wsavoie/HardwareSmarticles/README.md

# HardwareSmarticles
Contains all the relevant files for the hardware version of the smarticle as of 8/3/15
