wsavoie/HardwareSmarticles/Smarticle SolidWorks/Solar - Assembly.SLDASM

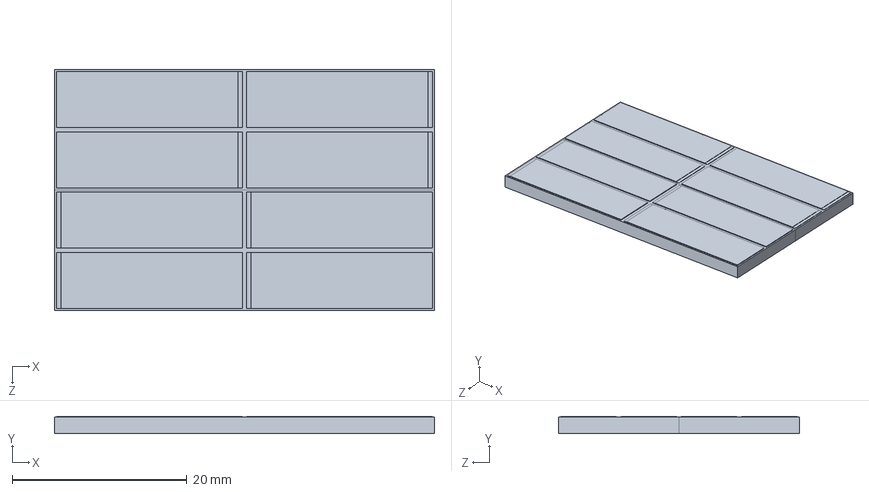
[picture p2: CAD file, 2015-08-03]
Smarticle SolidWorks/Solar - Assembly.SLDASM
43.5 x 2.00 x 27.6 mm
Arm - Solar Panel x 2
