wsavoie/HardwareSmarticles/Smarticle SolidWorks/Switch - Assembly.SLDASM

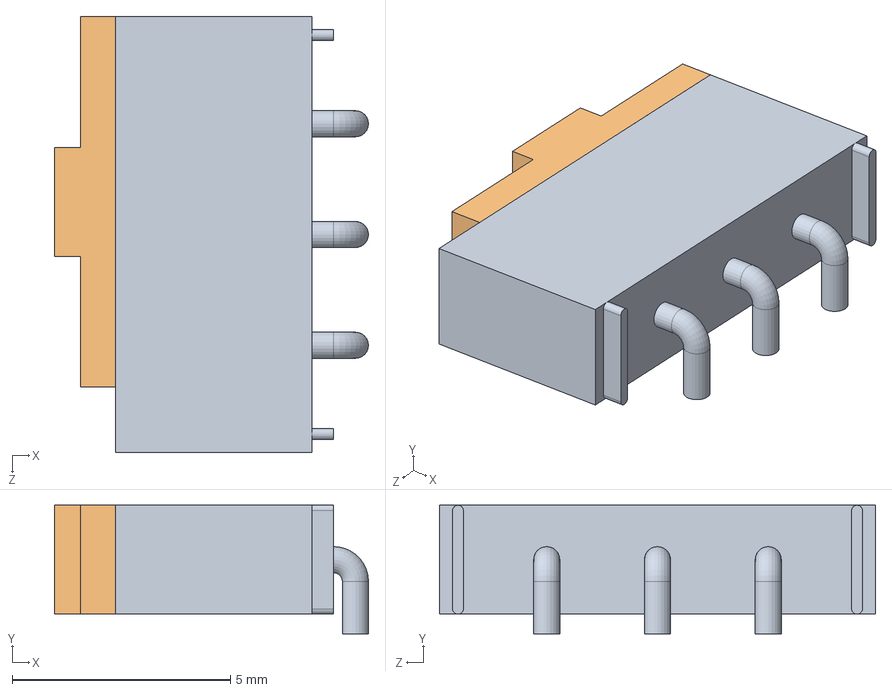
[picture p3: CAD file, 2015-08-03]
Smarticle SolidWorks/Switch - Assembly.SLDASM
7.20 x 2.95 x 10.0 mm
Switch - Body
Switch - Rocker
