wsavoie/HardwareSmarticles/Smarticle SolidWorks/Battery - Assembly.SLDASM

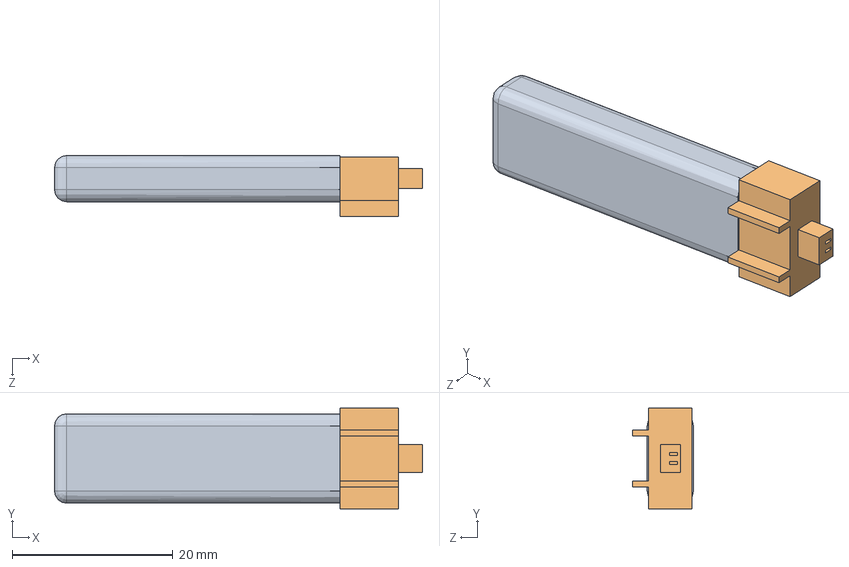
[picture p4: CAD file, 2015-08-03]
Smarticle SolidWorks/Battery - Assembly.SLDASM
45.8 x 12.5 x 7.57 mm
Battery - Body
Battery - Connector
