wsavoie/HardwareSmarticles/Smarticle SolidWorks/Servo - Assembly.SLDASM

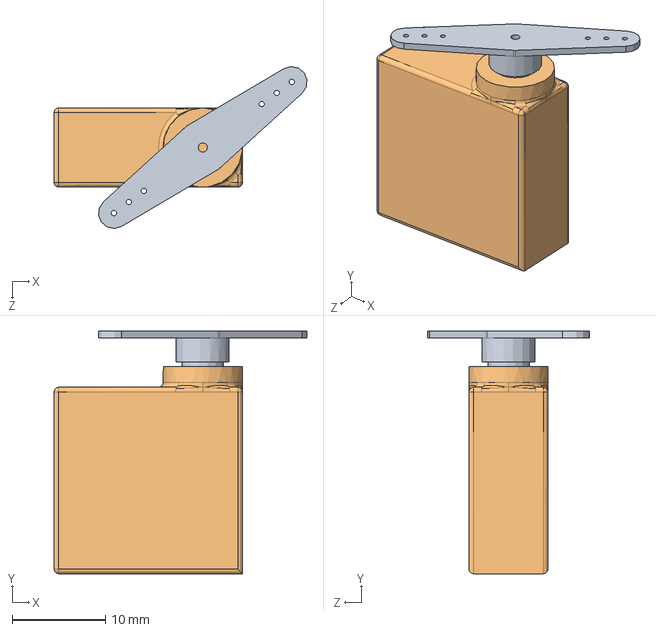
[picture p5: CAD file, 2015-08-03]
Smarticle SolidWorks/Servo - Assembly.SLDASM
27.1 x 26.0 x 17.4 mm
Servo - Body
Servo - Horn
