wsavoie/HardwareSmarticles/Smarticle SolidWorks/PCB - Assembly.SLDASM

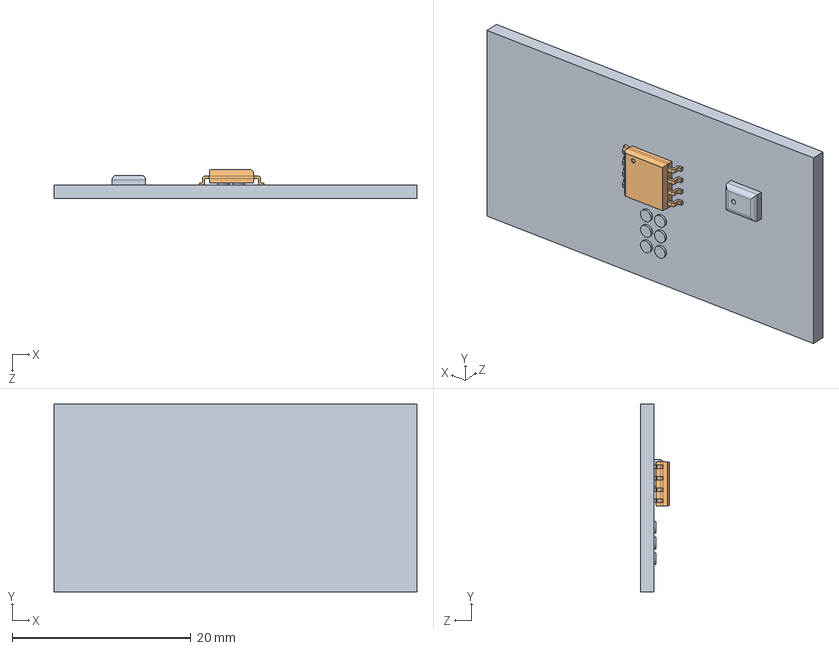
[picture p6: CAD file, 2015-08-03]
Smarticle SolidWorks/PCB - Assembly.SLDASM
40.6 x 21.0 x 3.25 mm
PCB - Board
PCB - Attiny85
