wsavoie/HardwareSmarticles/Smarticle SolidWorks/Smarticle - Front Cover.SLDPRT

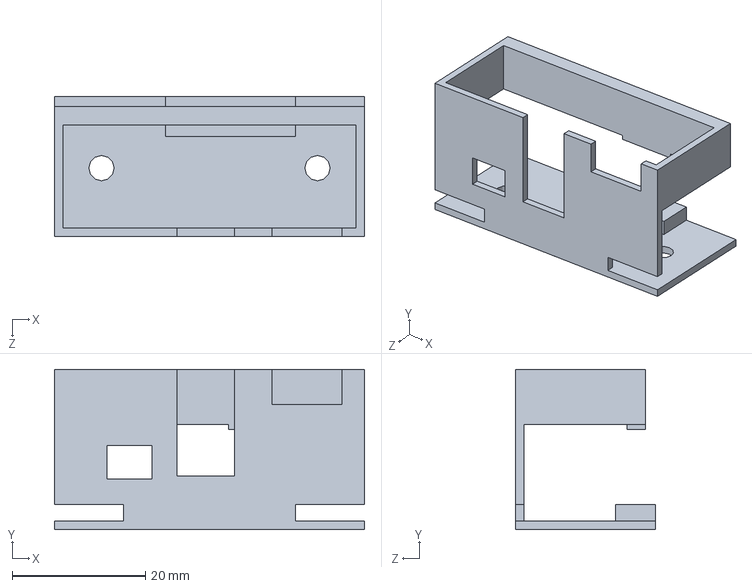
[picture p7: CAD file, 2015-11-16]
Smarticle SolidWorks/Smarticle - Front Cover.SLDPRT
46.5 x 24.0 x 21.0 mm
