wsavoie/HardwareSmarticles/Smarticle SolidWorks/Servo - Horn.SLDPRT

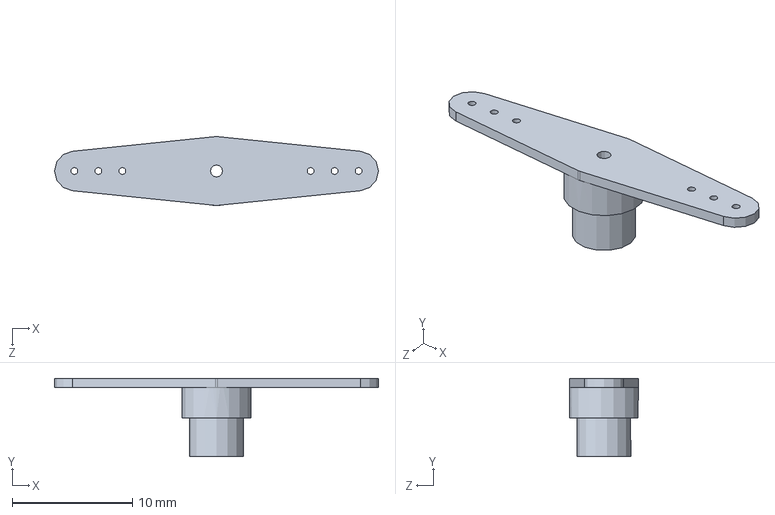
[picture p8: CAD file, 2015-08-03]
Smarticle SolidWorks/Servo - Horn.SLDPRT
27.0 x 6.50 x 5.75 mm
