wsavoie/HardwareSmarticles/Smarticle SolidWorks/PCB - VReg.SLDPRT

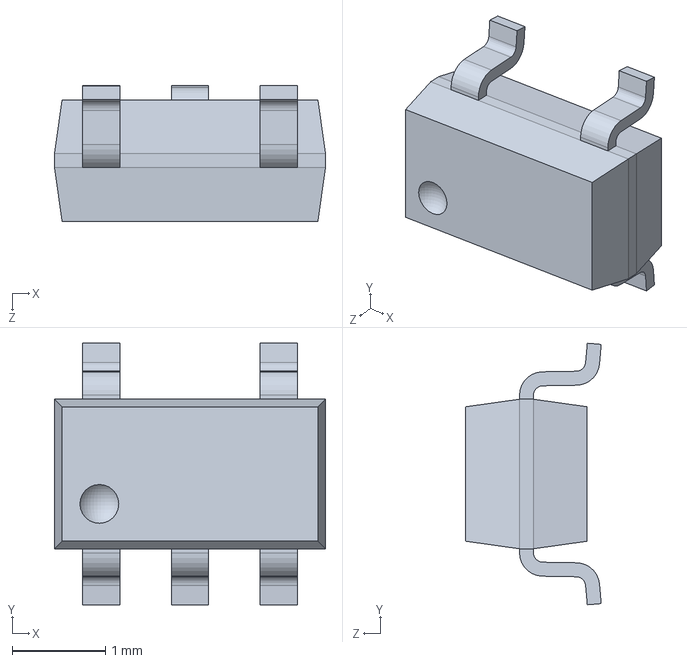
[picture p9: CAD file, 2015-08-03]
Smarticle SolidWorks/PCB - VReg.SLDPRT
2.90 x 2.80 x 1.45 mm
