wsavoie/HardwareSmarticles/Smarticle SolidWorks/Servo - Solar Arm.SLDPRT

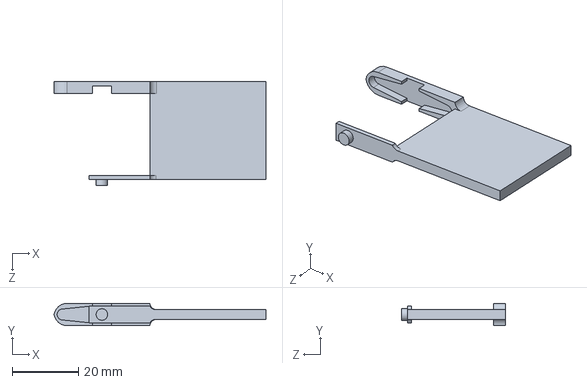
[picture p10: CAD file, 2015-08-03]
Smarticle SolidWorks/Servo - Solar Arm.SLDPRT
64.0 x 6.75 x 31.2 mm
