wsavoie/HardwareSmarticles/Smarticle SolidWorks/Arm - Solar Panel.SLDPRT

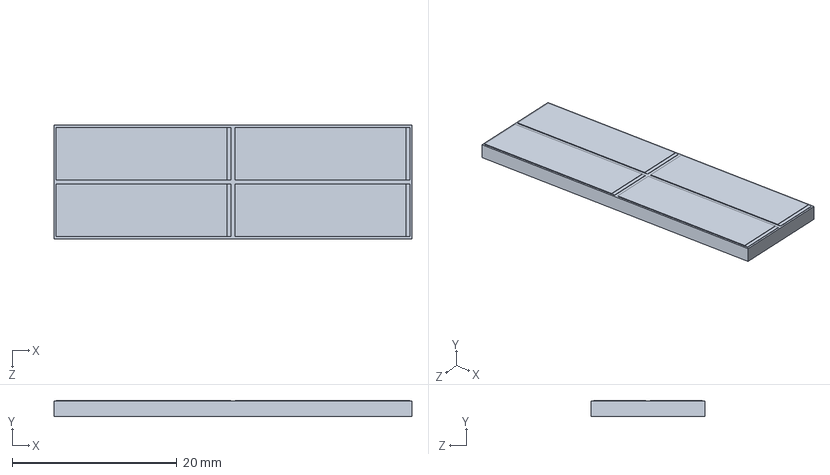
[picture p11: CAD file, 2015-08-03]
Smarticle SolidWorks/Arm - Solar Panel.SLDPRT
43.5 x 2.00 x 13.8 mm
