wsavoie/HardwareSmarticles/Smarticle SolidWorks/Battery - Connector.SLDPRT

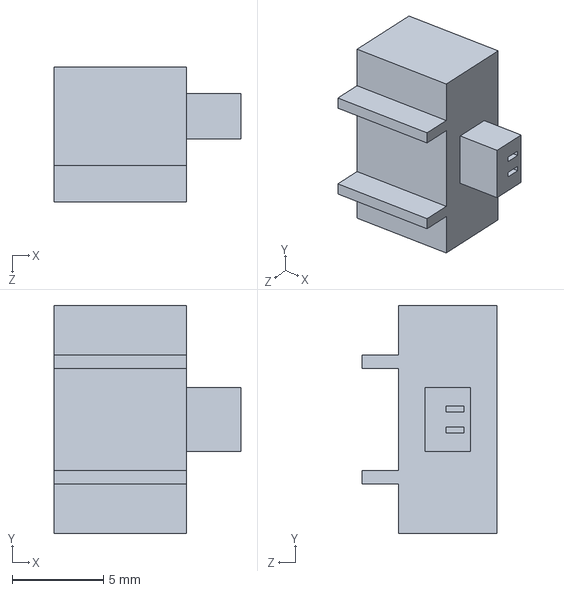
[picture p12: CAD file, 2015-08-03]
Smarticle SolidWorks/Battery - Connector.SLDPRT
10.2 x 12.5 x 7.40 mm
