wsavoie/HardwareSmarticles/Smarticle SolidWorks/PCB - Board.SLDPRT

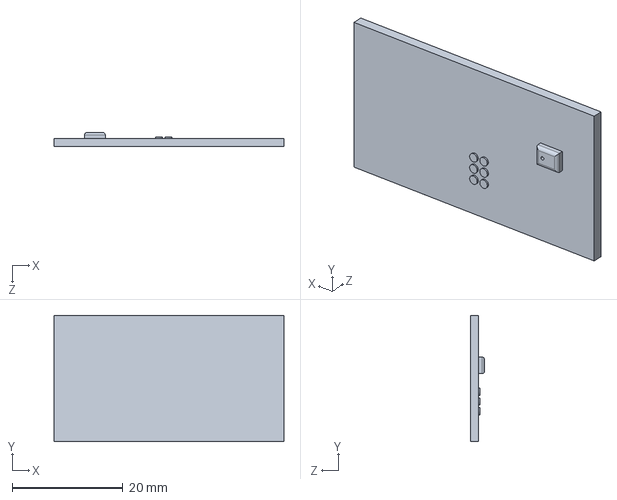
[picture p13: CAD file, 2015-08-03]
Smarticle SolidWorks/PCB - Board.SLDPRT
41.5 x 22.8 x 2.60 mm
