wsavoie/HardwareSmarticles/Smarticle SolidWorks/Battery - Body.SLDPRT

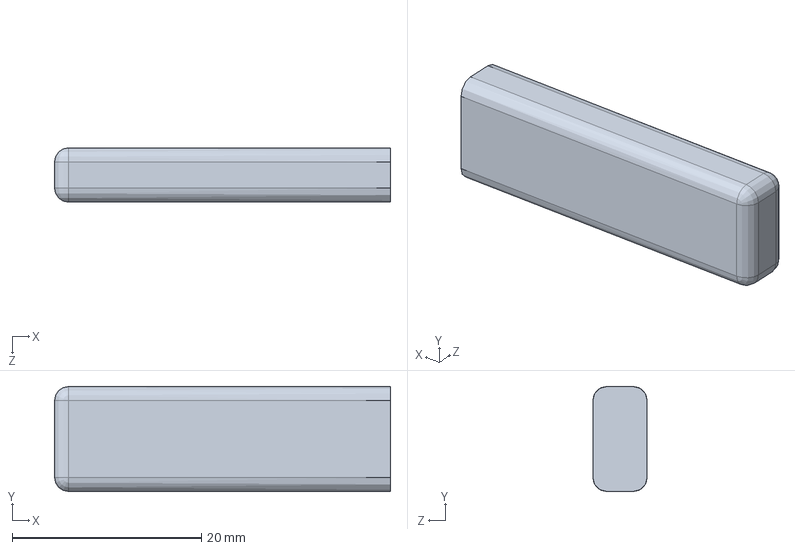
[picture p14: CAD file, 2015-08-03]
Smarticle SolidWorks/Battery - Body.SLDPRT
35.5 x 11.1 x 5.75 mm
