wsavoie/HardwareSmarticles/Smarticle SolidWorks/Switch - Rocker.SLDPRT

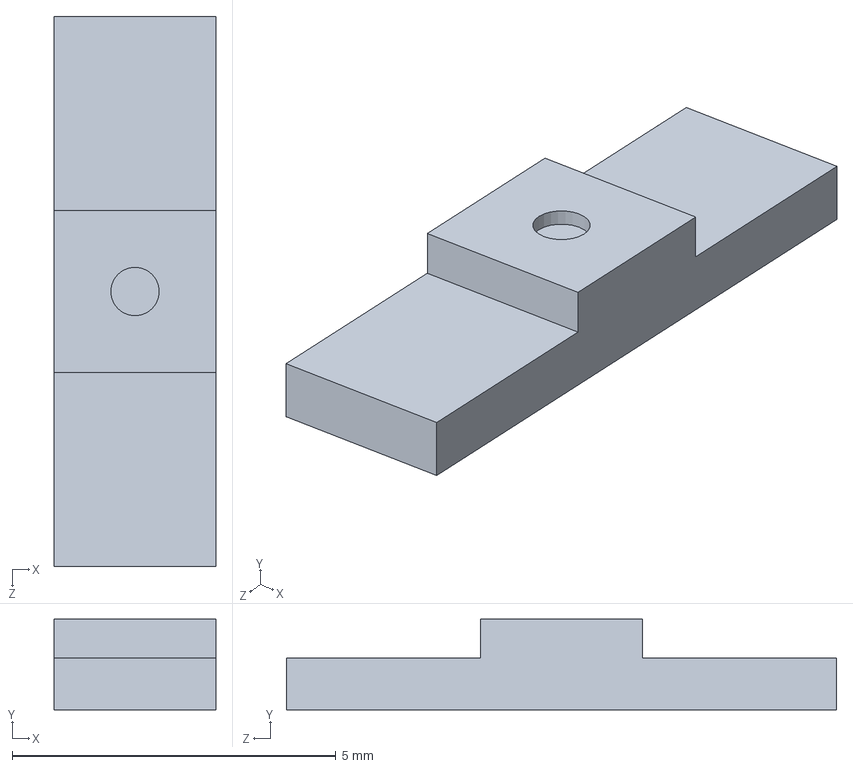
[picture p15: CAD file, 2015-08-03]
Smarticle SolidWorks/Switch - Rocker.SLDPRT
2.50 x 1.40 x 8.50 mm
