wsavoie/HardwareSmarticles/Smarticle SolidWorks/PCB - Solar Charger Chip.SLDPRT

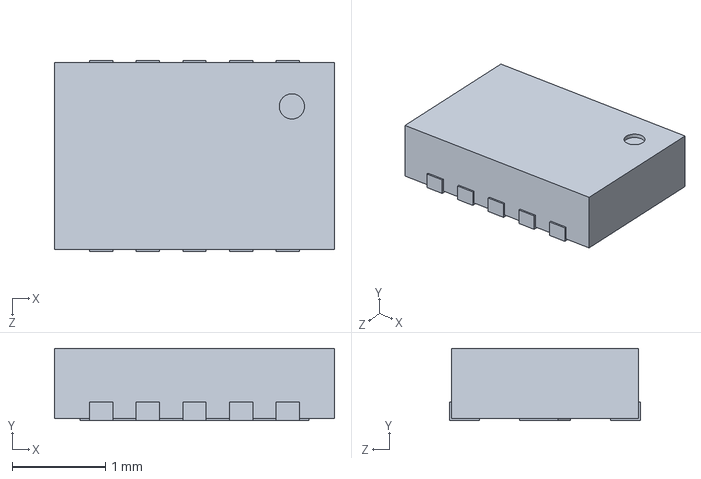
[picture p16: CAD file, 2015-08-03]
Smarticle SolidWorks/PCB - Solar Charger Chip.SLDPRT
3.00 x 0.775 x 2.05 mm
