wsavoie/HardwareSmarticles/Smarticle SolidWorks/PCB - Switch.SLDPRT

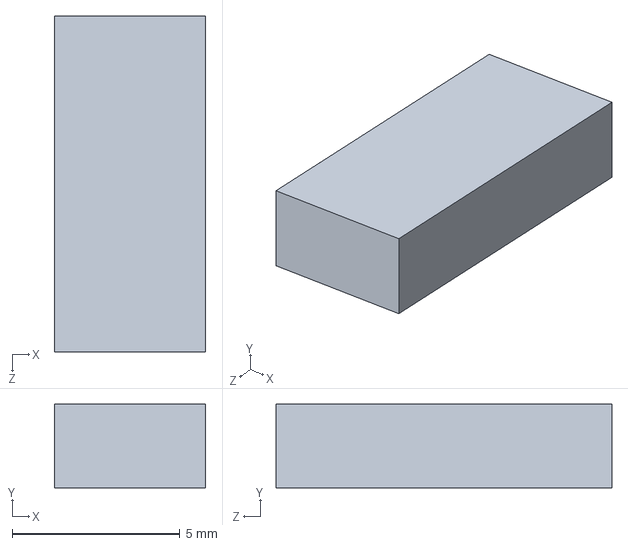
[picture p17: CAD file, 2015-08-03]
Smarticle SolidWorks/PCB - Switch.SLDPRT
4.50 x 2.50 x 10.0 mm
