wsavoie/HardwareSmarticles/Smarticle SolidWorks/Switch - Body.SLDPRT

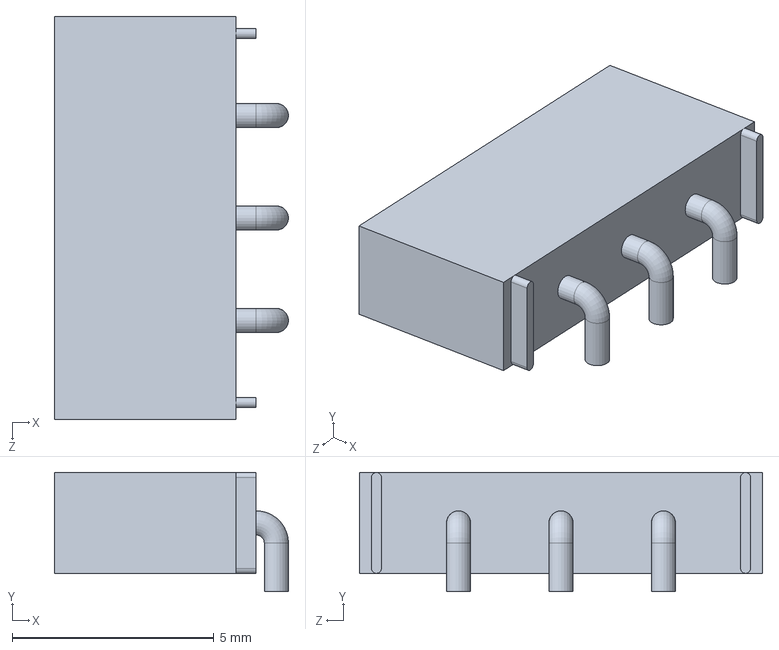
[picture p18: CAD file, 2015-08-03]
Smarticle SolidWorks/Switch - Body.SLDPRT
5.80 x 2.95 x 10.0 mm
