wsavoie/HardwareSmarticles/Smarticle SolidWorks/PCB - Attiny85.SLDPRT

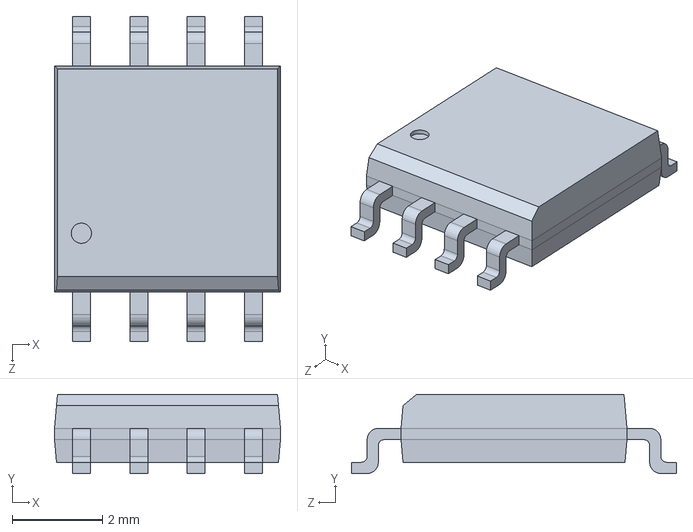
[picture p19: CAD file, 2015-08-03]
Smarticle SolidWorks/PCB - Attiny85.SLDPRT
5.00 x 1.75 x 7.20 mm
