wsavoie/HardwareSmarticles/Smarticle SolidWorks/Smarticle - Back Cover.SLDPRT

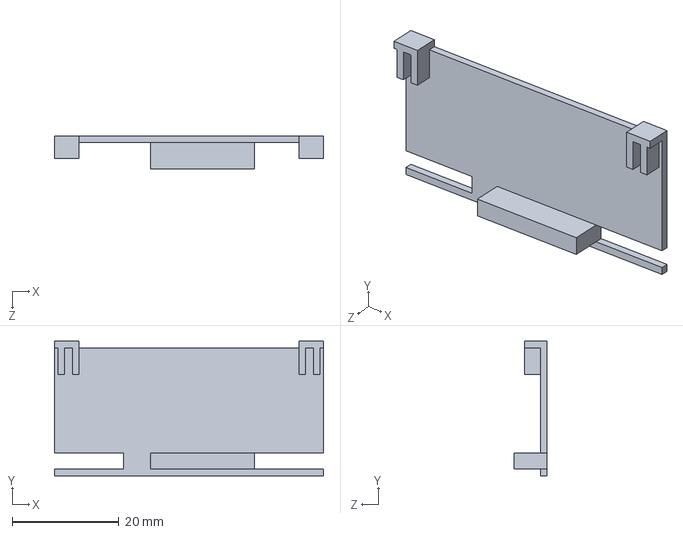
[picture p20: CAD file, 2015-08-03]
Smarticle SolidWorks/Smarticle - Back Cover.SLDPRT
50.5 x 25.2 x 6.25 mm
