wsavoie/HardwareSmarticles/Smarticle SolidWorks/Servo - Body.SLDPRT

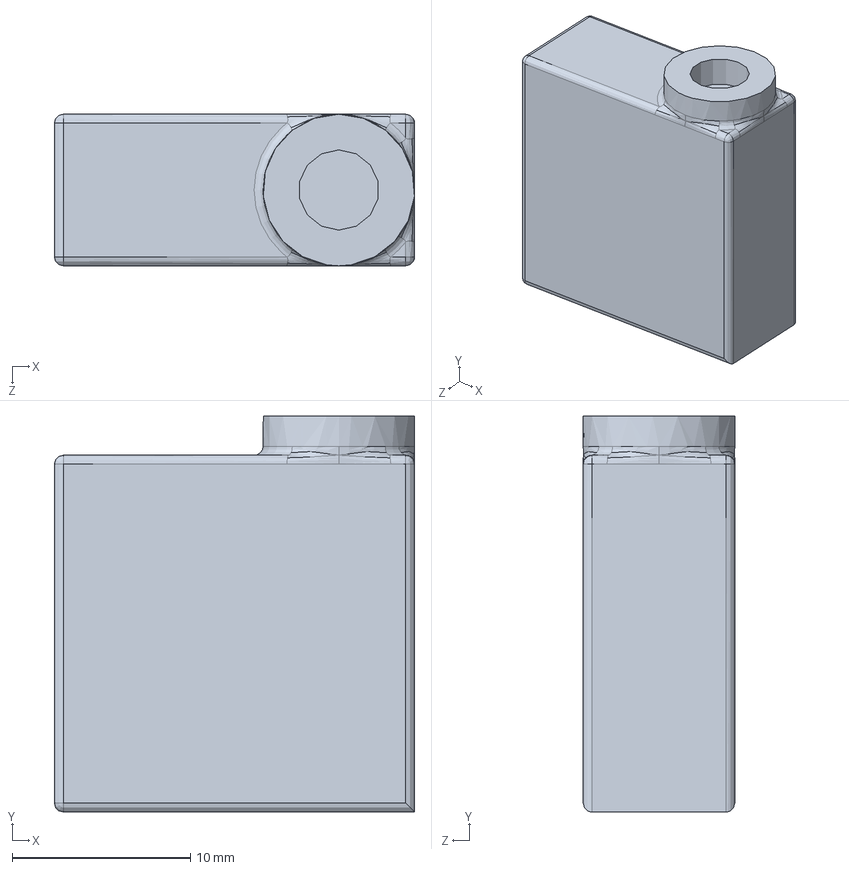
[picture p21: CAD file, 2015-08-03]
Smarticle SolidWorks/Servo - Body.SLDPRT
20.2 x 22.2 x 8.50 mm
