wsavoie/HardwareSmarticles/(list of files, cad)

Other CAD files:
Smarticle SolidWorks/PCB - OpAmp.SLDPRT
