wsavoie/HardwareSmarticles/Smarticle SolidWorks/Smarticle - Assembly.JPG

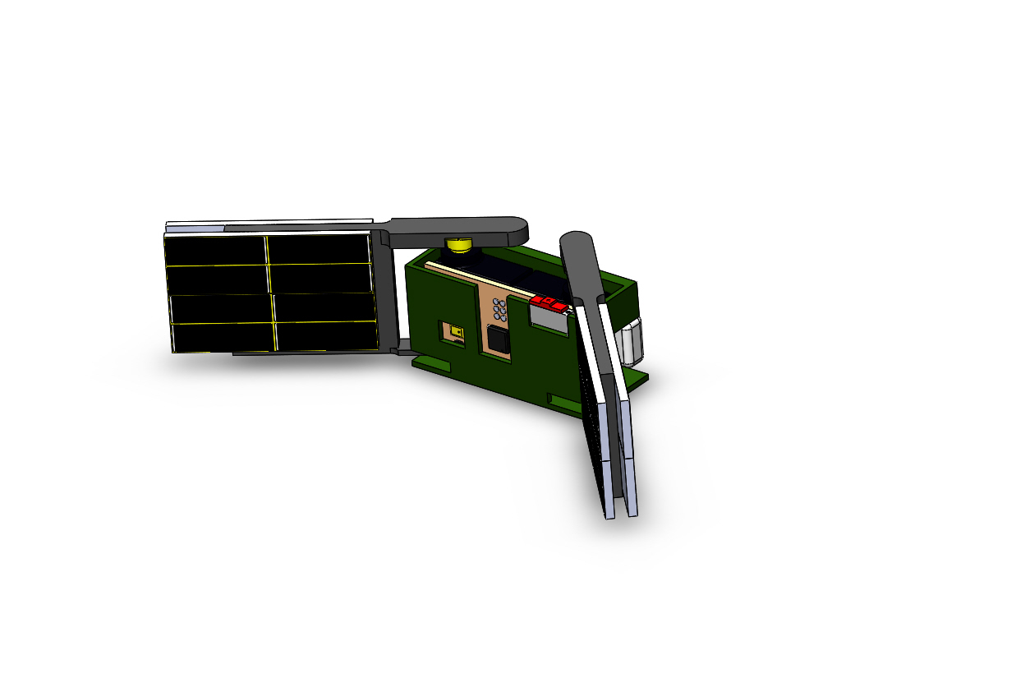
Smarticle SolidWorks/Smarticle - Assembly.JPG
