wsavoie/HardwareSmarticles/Smarticle Eagle/smarticle12.brd

## EAGLE design Smarticle Eagle/smarticle12.brd (2015-08-03)

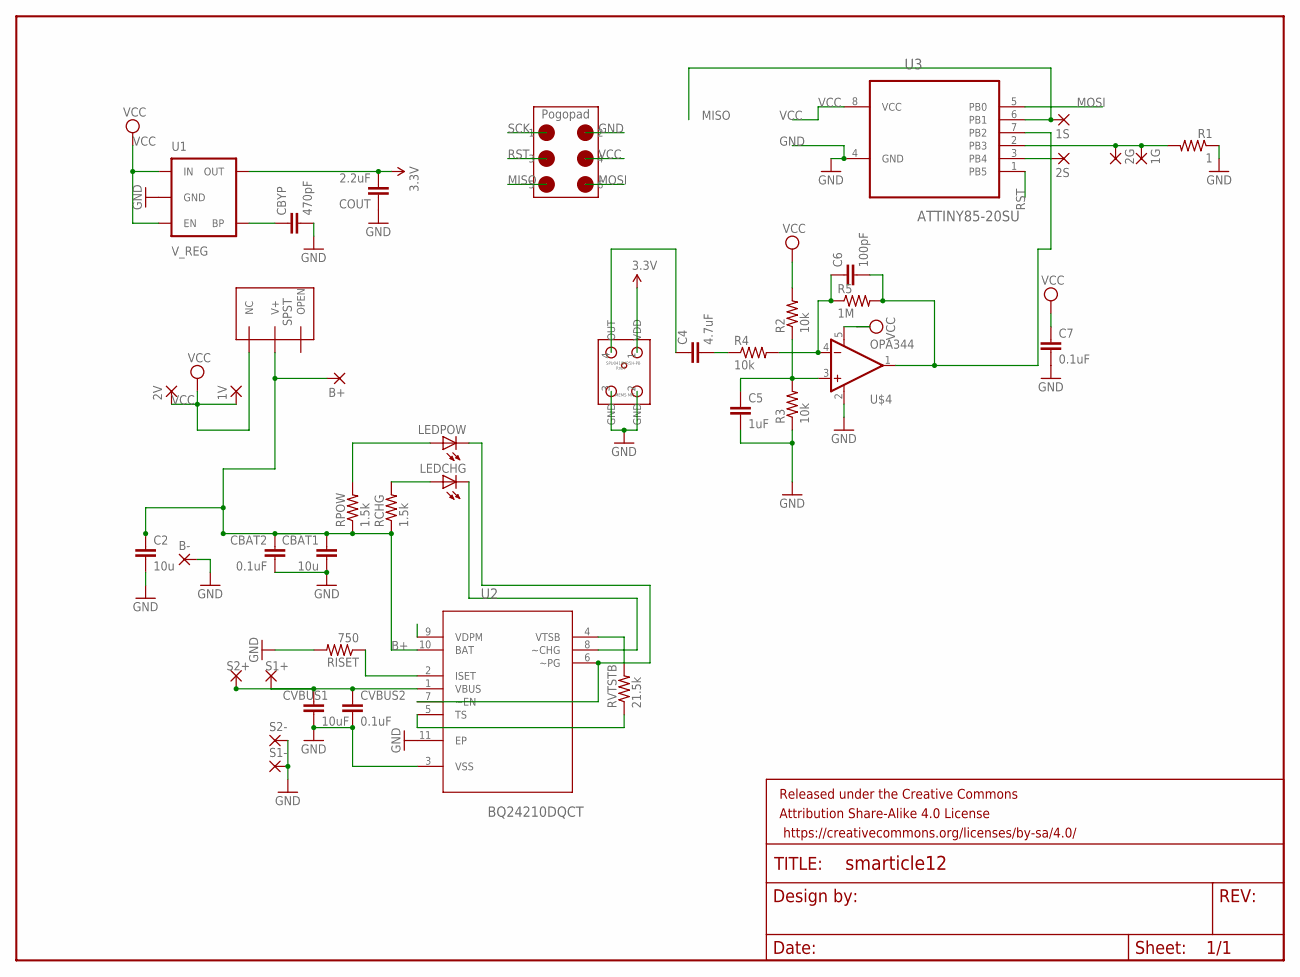
[picture p23: schematic smarticle12.sch]

Parts:
1G, 1S, 1V, 2G, 2S, 2V: 1,6/0,8
B+: 1,6/0,8
B-: 1,6/0,8
C2: 10u; 0603-CAP
C4: 4.7uF; 0603-CAP
C5: 1uF; 0603-CAP
C6: 100pF; 0603-CAP
C7: 0.1uF; 0603-CAP
CBAT1: 10u; 0805
CBAT2: 0.1uF; 0603-CAP
CBYP: 470pF; 0603-CAP
COUT: 2.2uF; 0603-CAP
CVBUS1: 10uF; 1206
CVBUS2: 0.1uF; 0603-CAP
FRAME1: FRAME-LETTERNO_PACKAGE; DUMMY
LEDCHG: LEDCHIPLED_0603; CHIPLED_0603
LEDPOW: LEDCHIPLED_0603; CHIPLED_0603
R1: 1; 0805
R2, R3, R4: 10k; 0603-RES
R5: 1M; 0603-RES
RCHG: 1.5k; 0603-RES
RISET: 750; 0603-RES
RPOW: 1.5k; 0603-RES
RVTSTB: 21.5k; 0603-RES
S1+, S1-, S2+, S2-: 1,6/0,8
U1: V_REG; SOT23-5
U2: BQ24210DQCT; SON50P200X300X80-11N
U3: ATTINY85-20SU; SOIC127P798X216-8N
U$1: 2X3POGOPADS; 3X2POGOPADS
U$2: WILL_SWITCH; WILL-SWITCH
U$3: MEMSMICRO; MEMSMIC
U$4: OPA344; SOT23-5

Connections:
3.3V: COUT.2, U1.5 (OUT), U$3.1 (VDD)
B+: B+.1, C2.1, CBAT1.1, CBAT2.1, RCHG.1, RPOW.1, U2.10 (BAT), U$2.V+
GND: B-.1, C2.2, C5.2, C7.2, CBAT1.2, CBAT2.2, CBYP.2, COUT.1, CVBUS1.2, CVBUS2.2, R1.1, R3.1, RISET.2, S1-.1, S2-.1, U1.2 (GND), U2.3 (VSS), U2.11 (EP), U3.4 (GND), U$1.2, U$3.2 (GND), U$3.3 (GND), U$4.2 (V-)
MISO: 1S.1, U3.6 (PB1), U$1.5
MOSI: U3.5 (PB0), U$1.6
unnamed: 2S.1, U3.3 (PB4)
unnamed: LEDPOW.A, RPOW.2
unnamed: LEDCHG.A, RCHG.2
unnamed: CBYP.1, U1.4 (BP)
unnamed: RVTSTB.1, U2.5 (TS)
unnamed: RVTSTB.2, U2.4 (VTSB)
unnamed: 1G.1, 2G.1, R1.2, U3.2 (PB3)
unnamed: CVBUS1.1, CVBUS2.1, S1+.1, S2+.1, U2.1 (VBUS)
unnamed: LEDPOW.C, U2.6 (~PG), U2.7 (~EN)
unnamed: RISET.1, U2.2 (ISET)
unnamed: C4.1, U$3.4 (OUT)
unnamed: LEDCHG.C, U2.8 (~CHG)
unnamed: C4.2, R4.1
unnamed: C5.1, R2.1, R3.2, U$4.3 (+IN)
unnamed: C6.1, R4.2, R5.1, U$4.4 (-IN)
RST: U3.1 (PB5), U$1.3
SCK: C6.2, R5.2, U3.7 (PB2), U$1.1, U$4.1 (OUT)
VCC: 1V.1, 2V.1, C7.1, R2.2, U1.1 (IN), U1.3 (EN), U3.8 (VCC), U$1.4, U$2.NC, U$4.5 (V+)

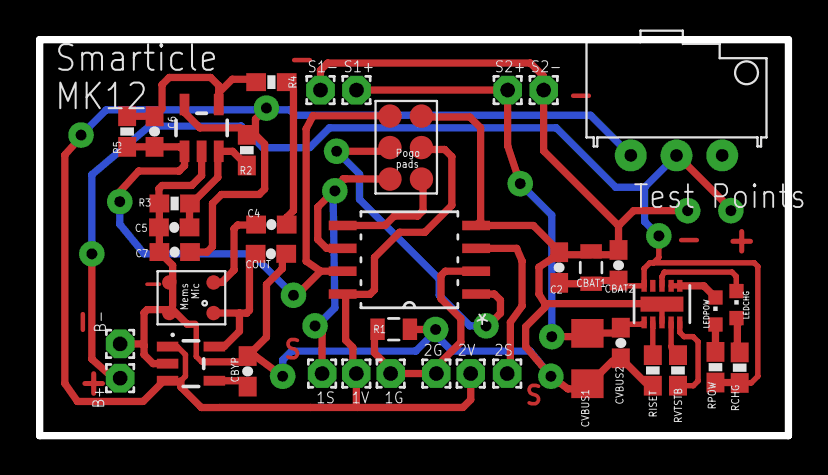
[picture p24: board smarticle12.brd from above]

Board: 2 copper layers, 41.6 x 22.0 mm, 42 parts (0 on the bottom side), 23 nets.
