wsavoie/HardwareSmarticles/(commit log)

2015-08-03 added smarticle eagle files
    [smarticle12.brd, smarticle12.sch]
2015-08-03 added solidworks files
    [Arm - Solar Panel.SLDPRT, Battery - Assembly.SLDASM, Battery - Body.SLDPRT, Battery - Connector.SLDPRT, PCB - Assembly.SLDASM, PCB - Attiny85.SLDPRT, PCB - Board.SLDPRT, PCB - OpAmp.SLDPRT]
2015-11-16 edited at some point?
    [Smarticle - Assembly.SLDASM, Smarticle - Front Cover.SLDPRT]
